jerrygacket/lcd-gprs-relay-arduino/схема подключения.png

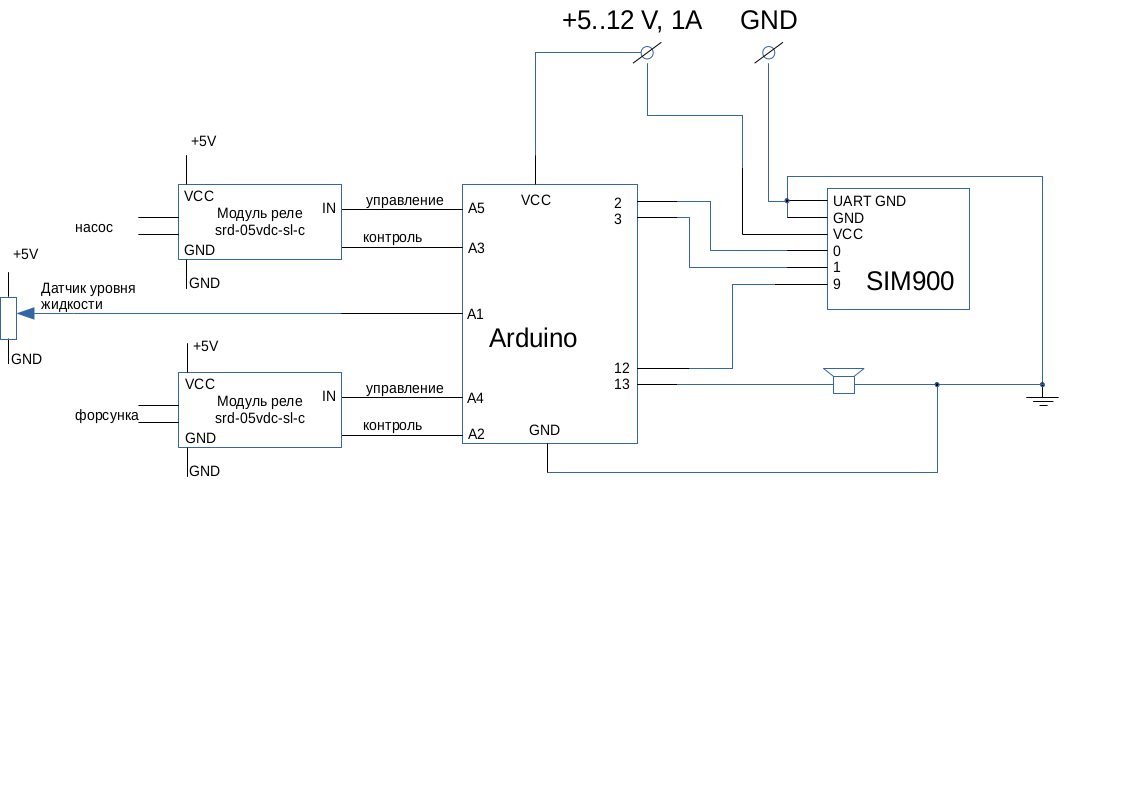
схема подключения.png
